wassim-tk/PCB-DC-Motor-Speed-Control/MP_Electronique_2025_liste_composants.pdf

Qté | Désignation | Valeur
1 | barrette sécable mâle (Pin Header) | 1x10 broches - 2.54mm
2 | bornier | à deux vis
2 | bornier | à trois vis
2 | bouton poussoir Omron | à souder sur circuit imprimé
1 | circuit intégré en boîtier DIP | 4027N
1 | circuit intégré en boîtier DIP | LM393N
1 | circuit intégré en boîtier DIP | NE555N
1 | circuit intégré en boîtier DIP | µA741
5 | condensateur céramique | 100nF
1 | condensateur céramique | 10nF
1 | condensateur céramique | 1nF
2 | condensateur chimique | 10µF/25V
5 | condensateur chimique | 1µF/25V
2 | condensateur chimique | 2200µF/25V
1 | condensateur plastique ou mica | 330nF/100V
5 | diode | 1N4004
3 | diode | 1N4148 ou 1N914
1 | diode | BYT08P-400 ou équivalent
4 | entretoise filetée hexagonale mâle/femelle + écrou | M3
2 | LED 5mm | rouge
3 | LED 5mm | verte
1 | MOSFET | IRF530
0,5 | plaque de circuit imprimé epoxy présensibilisée simple face | 300x200mm
1 | potentiomètre avec axe 6mm | 10K
1 | régulateur de tension | 7812
1 | régulateur de tension | 7912
1 | régulateur de tension | LM317T
1 | relais 12V à deux contacts inverseurs 5A/250V | G2R2
1 | résistance 1/4W | 10 ohm
10 | résistance 1/4W | 10K
1 | résistance 1/4W | 15K
6 | résistance 1/4W | 1K
1 | résistance 1/4W | 220 ohm
1 | résistance 1/4W | 22K
1 | résistance 1/4W | 4.7K
2 | résistance 1/4W | 470 ohm
2 | résistance 1/4W | 47K
1 | résistance 1/4W | 6,8K
1 | résistance ajustable horizontale 10mm | 2.2K
1 | résistance ajustable horizontale 10mm | 470 ohm
1 | support de circuit intégré LC | 16 broches
3 | support de circuit intégré LC | 8 broches
1 | transformateur | 220V/2x12V/12VA
1 | transistor NPN en boîtier métallique TO18 | 2N2222
2 | transistor NPN | BC547
3 | transistor PNP | BC557
