wassim-tk/PCB-DC-Motor-Speed-Control/final tempo/tempo_liste_comp.pdf

Qty | Description | Valeur
1 | bouton poussoir Omron | à souder sur circuit imprimé
1 | bornier | à deux vis
1 | résistance 1/4W | 1k
2 | résistance 1/4W | 10k
1 | résistance 1/4W | 100k
1 | Potentiometer | 1M
2 | condensateur céramique | 10nF /25V
1 | condensateur chimique | 100uF /25V
1 | diode | 1N4004
1 | diode | 1N4148DO35-10
1 | circuit intégré en boîtier DIP | NE555N
1 | LED 5mm | Rouge
1 | support de circuit intégré LC | 8 broches
