wassim-tk/PCB-DC-Motor-Speed-Control/rapport/hydro.png

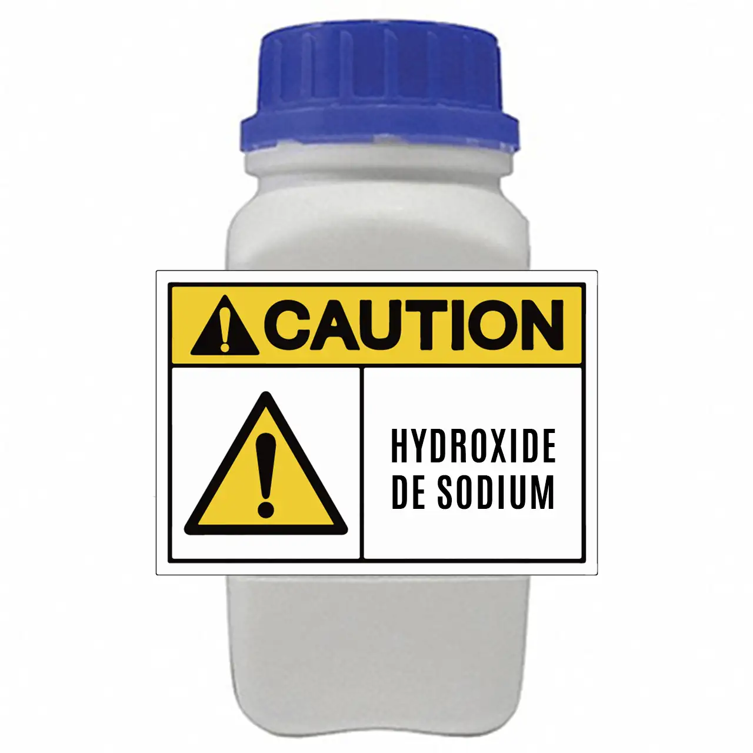
rapport/hydro.png
