wassim-tk/PCB-DC-Motor-Speed-Control/rapport/insoleuse.png

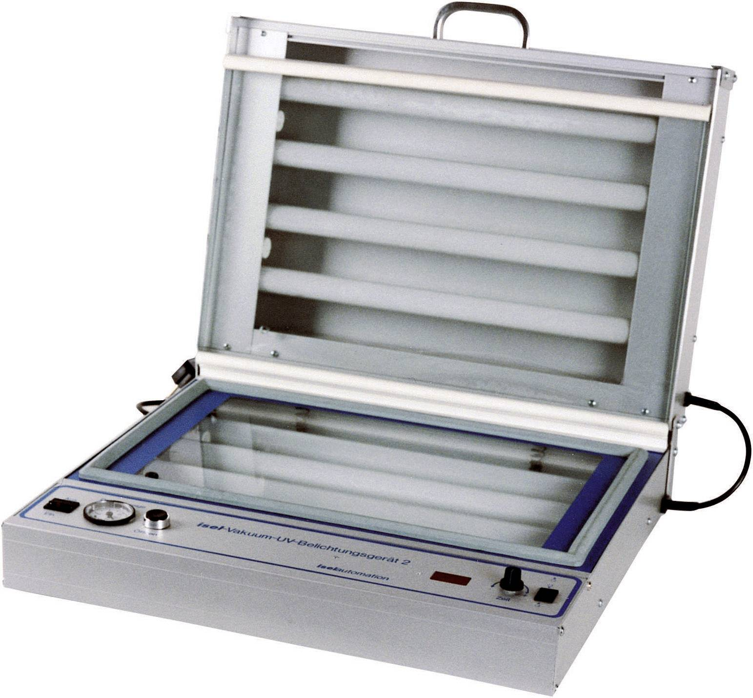
rapport/insoleuse.png
