wassim-tk/PCB-DC-Motor-Speed-Control/rapport/perch.png

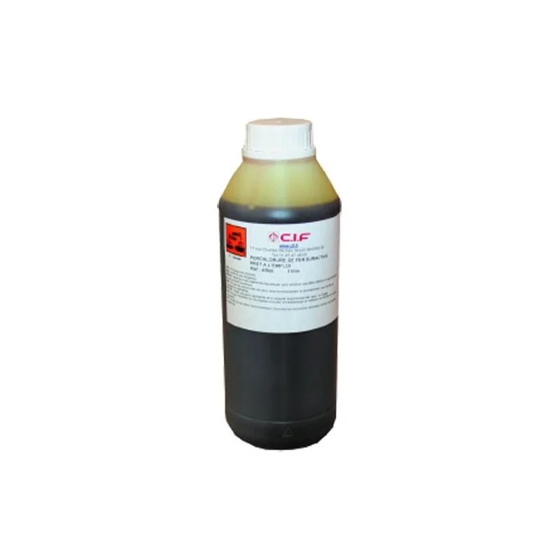
rapport/perch.png
