wassim-tk/PCB-DC-Motor-Speed-Control/rapport/sch.png

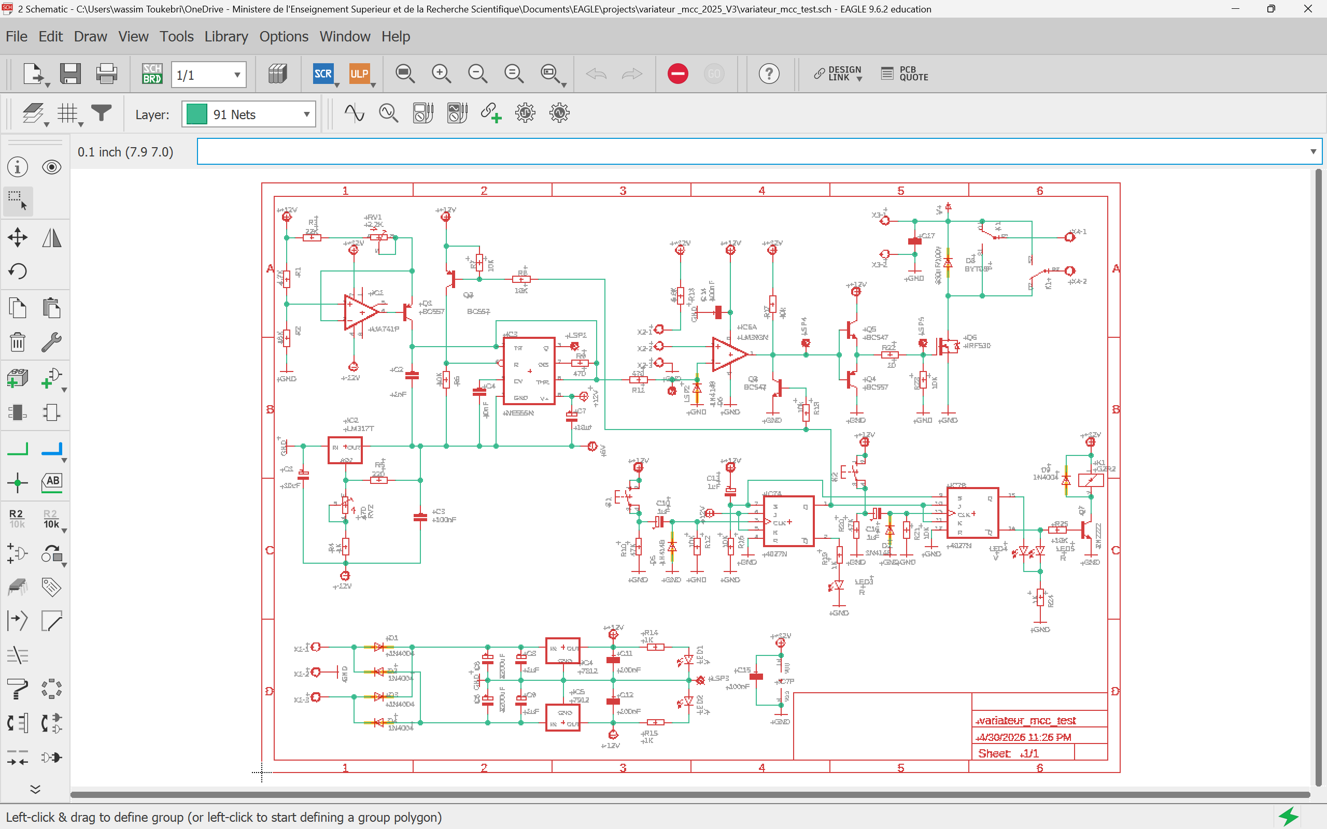
rapport/sch.png
