wassim-tk/PCB-DC-Motor-Speed-Control/rapport/sch_led_1.png

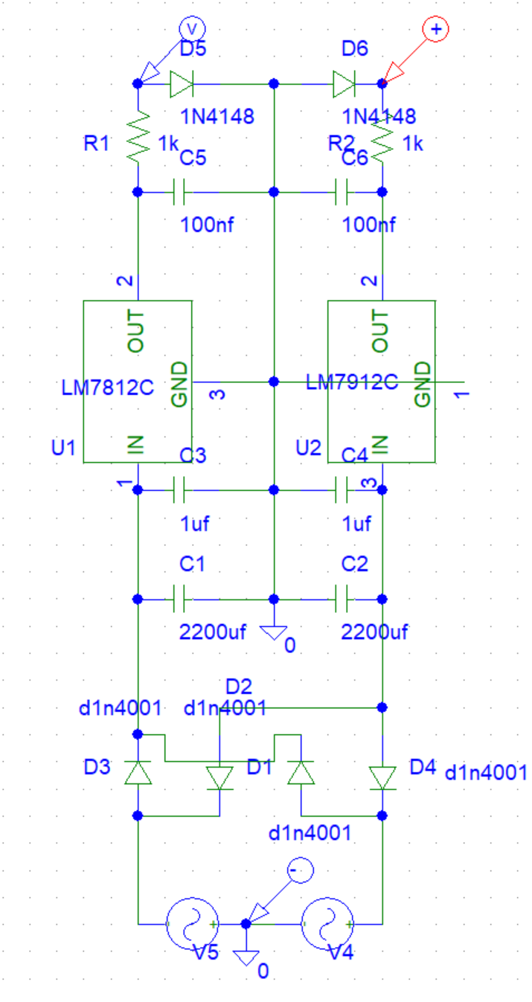
rapport/sch_led_1.png
