wassim-tk/PCB-DC-Motor-Speed-Control/rapport/sch_led_2.png

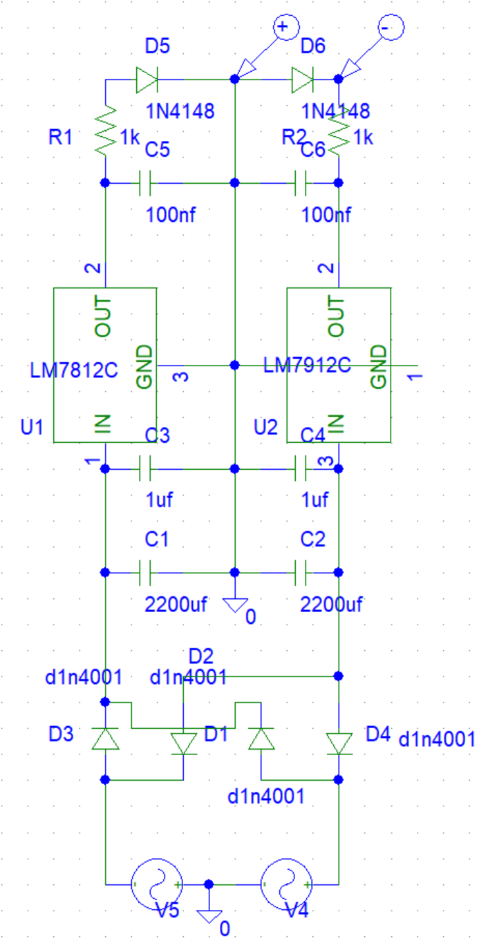
rapport/sch_led_2.png
