wassim-tk/PCB-DC-Motor-Speed-Control/rapport/sch_red.png

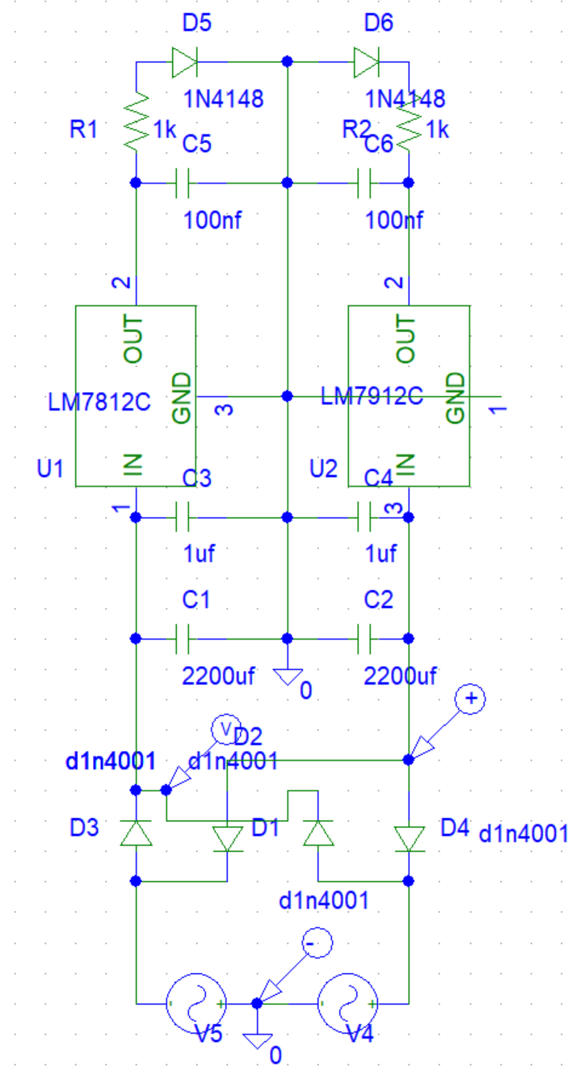
rapport/sch_red.png
