wassim-tk/PCB-DC-Motor-Speed-Control/rapport/sch_reg.png

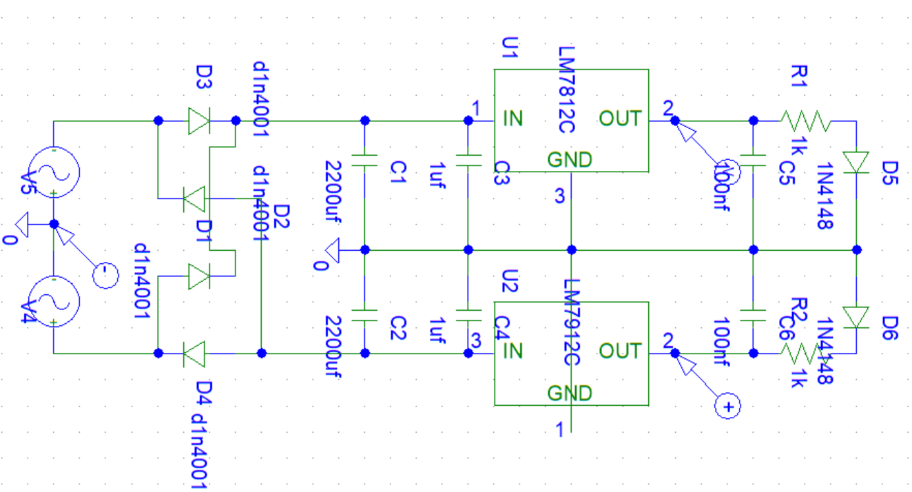
rapport/sch_reg.png
