wassim-tk/PCB-DC-Motor-Speed-Control/rapport/sim_led.png

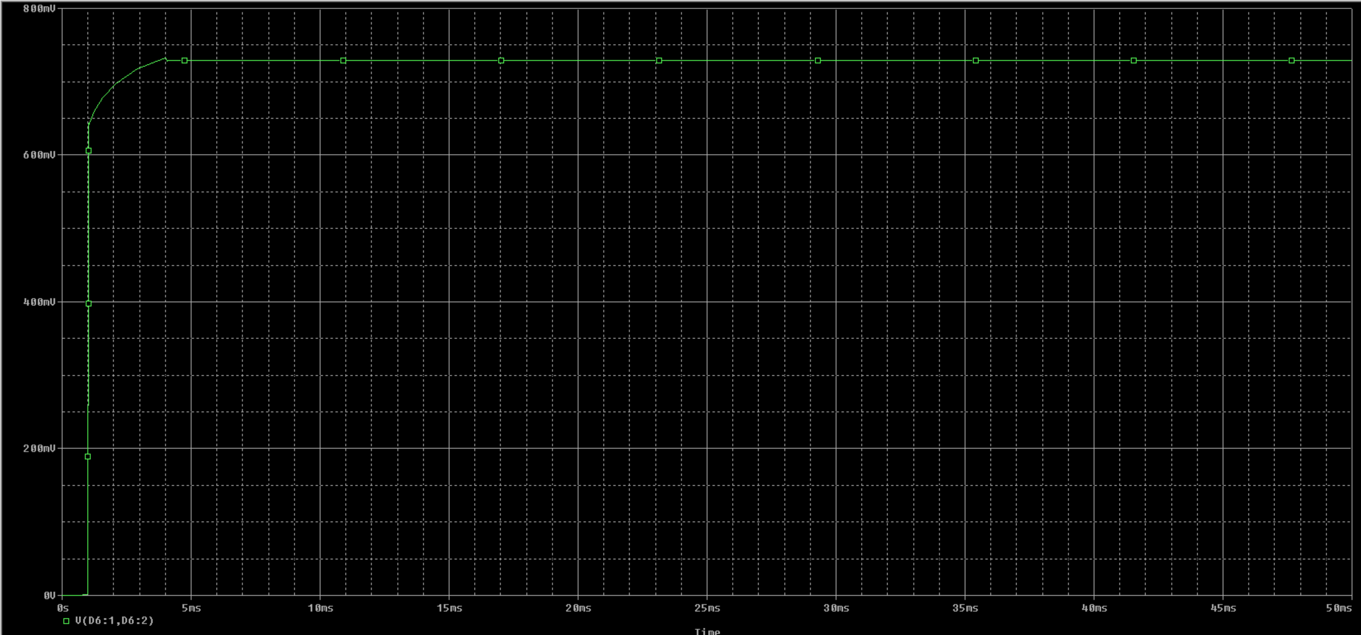
rapport/sim_led.png
