wassim-tk/PCB-DC-Motor-Speed-Control/rapport/soudage.png

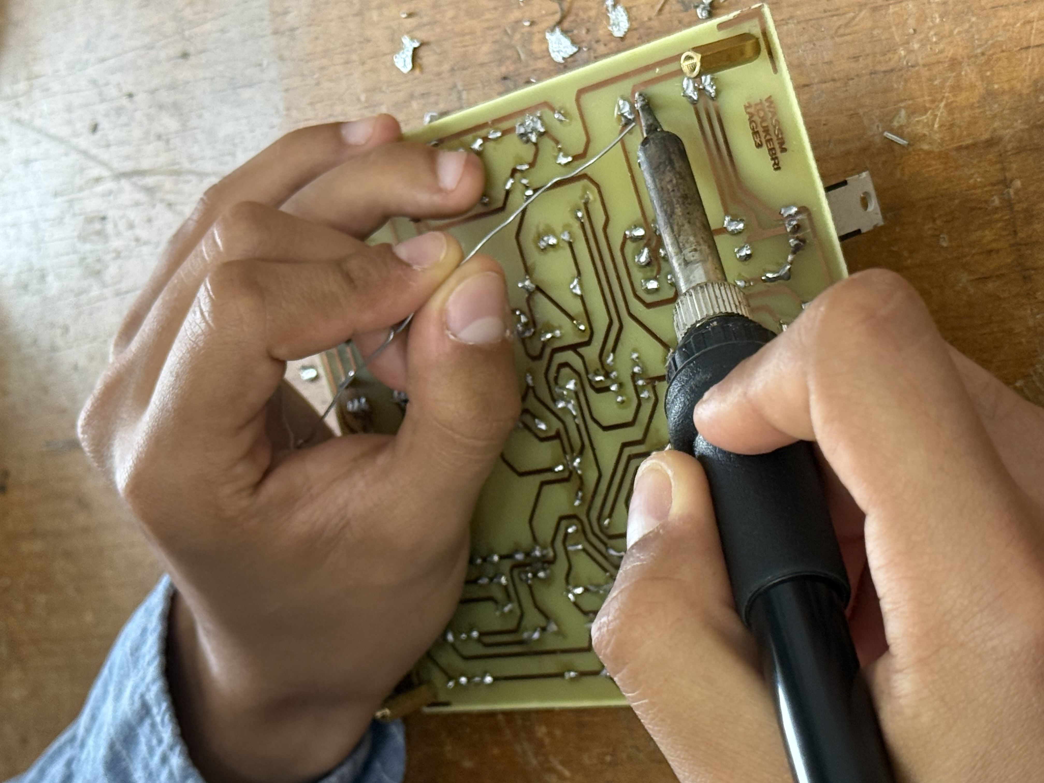
rapport/soudage.png
