wassim-tk/PCB-DC-Motor-Speed-Control/rapport/UV.jpg

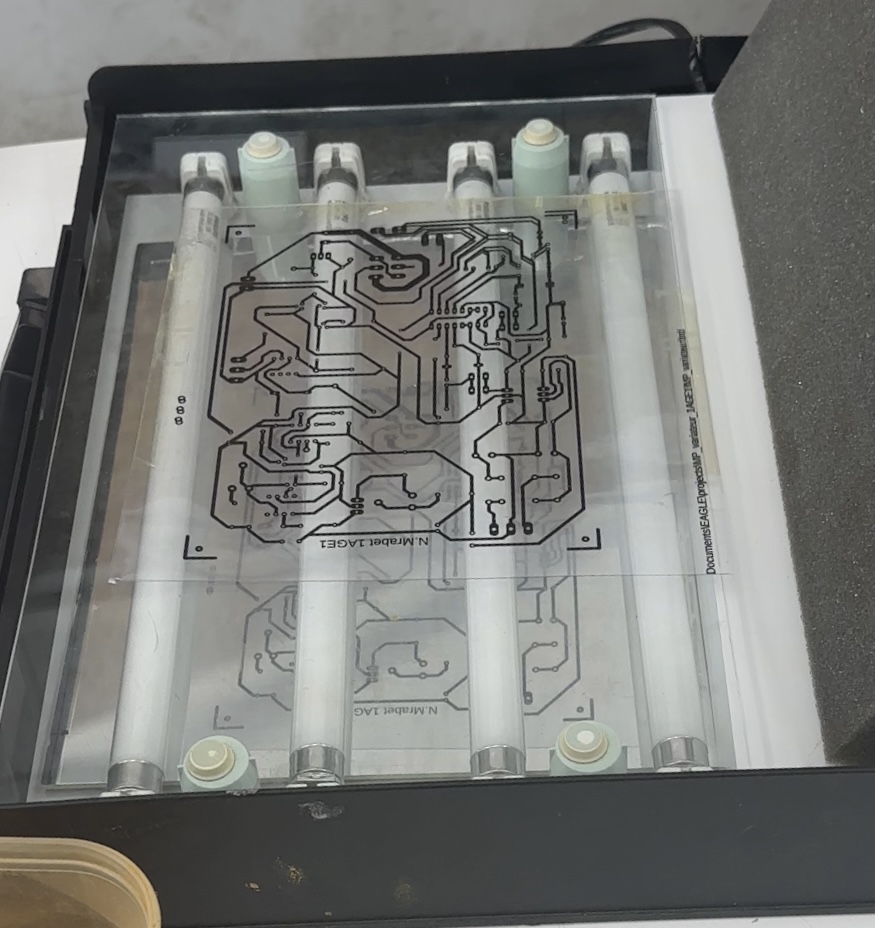
rapport/UV.jpg
