wassim-tk/PCB-DC-Motor-Speed-Control/rapport/partlist_variateur_mcc.xlsx

Sheet: Parts List
variateur_mcc_test - Parts List
Exported: 5/7/2026 10:07 PM | Project: variateur_mcc_2025_V3
Part | Value | Device | Package | Description | Category
C1 | 10uF | CPOL-EUE2.5-5 | E2,5-5 | POLARIZED CAPACITOR, European symbol | Capacitor
C2 | 1nF | C-EU050-030X075 | C050-030X075 | CAPACITOR, European symbol | Capacitor
C3 | 100nF | C-EU050-030X075 | C050-030X075 | CAPACITOR, European symbol | Capacitor
C4 | 10nF | C-EU050-030X075 | C050-030X075 | CAPACITOR, European symbol | Capacitor
C5 | 2200uF | CPOL-EUE5-13 | E5-13 | POLARIZED CAPACITOR, European symbol | Capacitor
C6 | 2200uF | CPOL-EUE5-13 | E5-13 | POLARIZED CAPACITOR, European symbol | Capacitor
C7 | 10uf | CPOL-EUE2.5-5 | E2,5-5 | POLARIZED CAPACITOR, European symbol | Capacitor
C8 | 1uF | CPOL-EUE2.5-5 | E2,5-5 | POLARIZED CAPACITOR, European symbol | Capacitor
C9 | 1uF | CPOL-EUE2.5-5 | E2,5-5 | POLARIZED CAPACITOR, European symbol | Capacitor
C10 | 1uF | CPOL-EUE2.5-5 | E2,5-5 | POLARIZED CAPACITOR, European symbol | Capacitor
C11 | 100nF | C-EU050-030X075 | C050-030X075 | CAPACITOR, European symbol | Capacitor
C12 | 100nF | C-EU050-030X075 | C050-030X075 | CAPACITOR, European symbol | Capacitor
C13 | 1uF | CPOL-EUE2.5-5 | E2,5-5 | POLARIZED CAPACITOR, European symbol | Capacitor
C14 | 100nF | C-EU050-030X075 | C050-030X075 | CAPACITOR, European symbol | Capacitor
C15 | 100nF | C-EU050-030X075 | C050-030X075 | CAPACITOR, European symbol | Capacitor
C16 | 1uF | CPOL-EUE2.5-5 | E2,5-5 | POLARIZED CAPACITOR, European symbol | Capacitor
C17 | 330nF/100v | C-EU150-054X183 | C150-054X183 | CAPACITOR, European symbol | Capacitor
D1 | 1N4004 | 1N4004 | DO41-10 | DIODE | Diode
D2 | 1N4004 | 1N4004 | DO41-10 | DIODE | Diode
D3 | 1N4004 | 1N4004 | DO41-10 | DIODE | Diode
D4 | 1N4004 | 1N4004 | DO41-10 | DIODE | Diode
D5 | 1N4148 | 1N4148DO35-10 | DO35-10 | DIODE | Diode
D6 | 1N4148 | 1N4148DO35-10 | DO35-10 | DIODE | Diode
D7 | 1N4148 | 1N4148DO35-10 | DO35-10 | DIODE | Diode
D8 | BYT08P | BYT08P | TO220ACS | DIODE | Diode
D9 | 1N4004 | 1N4004 | DO41-10 | DIODE | Diode
IC1 | UA741P | UA741P | DIL08 | OP AMP | IC
IC2 | LM317T | LM317TS | 317TS | VOLTAGE REGULATOR | IC
IC3 | NE555N | NE555N | DIL08 | TIMER | IC
IC4 | 7812 | 78XXS | 78XXS | VOLTAGE REGULATOR | IC
IC5 | 7912 | 79XXS | 79XXS | VOLTAGE REGULATOR | IC
IC6 | LM393N | LM393N | DIL08 | COMPARATOR | IC
IC7 | 4027N | 4027N | DIL16 | Dual JK FLIP FLOP | IC
K1 | G2R2 | G2R2 | G2R2 | RELAY | Relay
LED1 | V | LED5MM | LED5MM | LED | LED
LED2 | V | LED5MM | LED5MM | LED | LED
LED3 | R | LED5MM | LED5MM | LED | LED
LED4 | V | LED5MM | LED5MM | LED | LED
LED5 | R | LED5MM | LED5MM | LED | LED
LSP1 | LSP10 | LSP10 | LSP10 | SOLDER PAD drill 1.0 mm | Solder Pad
LSP2 | LSP10 | LSP10 | LSP10 | SOLDER PAD drill 1.0 mm | Solder Pad
LSP3 | LSP10 | LSP10 | LSP10 | SOLDER PAD drill 1.0 mm | Solder Pad
LSP4 | LSP10 | LSP10 | LSP10 | SOLDER PAD drill 1.0 mm | Solder Pad
LSP5 | LSP10 | LSP10 | LSP10 | SOLDER PAD drill 1.0 mm | Solder Pad
Q1 | BC557 | BC557 | TO92 | PNP Transistor | Transistor
Q2 | BC557 | BC557 | TO92 | PNP Transistor | Transistor
Q3 | BC547 | BC547 | TO92 | NPN TRANSISTOR | Transistor
Q4 | BC557 | BC557 | TO92 | PNP Transistor | Transistor
Q5 | BC547 | BC547 | TO92 | NPN TRANSISTOR | Transistor
Q6 | IRF530 | IRF530 | TO220BV | HEXFET Power MOSFET | Transistor
Q7 | 2N2222 | 2N2222 | TO18 | NPN TRANSISTOR | Transistor
R1 | 4.7K | R-EU_0207/10 | 0207/10 | RESISTOR, European symbol | Resistor
R2 | 15K | R-EU_0207/10 | 0207/10 | RESISTOR, European symbol | Resistor
R3 | 22K | R-EU_0207/10 | 0207/10 | RESISTOR, European symbol | Resistor
R4 | 1K | R-EU_0207/10 | 0207/10 | RESISTOR, European symbol | Resistor
R5 | 220 | R-EU_0207/10 | 0207/10 | RESISTOR, European symbol | Resistor
R6 | 10K | R-EU_0207/10 | 0207/10 | RESISTOR, European symbol | Resistor
R7 | 10K | R-EU_0207/10 | 0207/10 | RESISTOR, European symbol | Resistor
R8 | 10K | R-EU_0207/10 | 0207/10 | RESISTOR, European symbol | Resistor
R9 | 470 | R-EU_0207/10 | 0207/10 | RESISTOR, European symbol | Resistor
R10 | 47K | R-EU_0207/10 | 0207/10 | RESISTOR, European symbol | Resistor
R11 | 470 | R-EU_0207/10 | 0207/10 | RESISTOR, European symbol | Resistor
R12 | 10K | R-EU_0207/10 | 0207/10 | RESISTOR, European symbol | Resistor
R13 | 6.8K | R-EU_0207/10 | 0207/10 | RESISTOR, European symbol | Resistor
R14 | 1K | R-EU_0207/10 | 0207/10 | RESISTOR, European symbol | Resistor
R15 | 1K | R-EU_0207/10 | 0207/10 | RESISTOR, European symbol | Resistor
R16 | 10K | R-EU_0207/10 | 0207/10 | RESISTOR, European symbol | Resistor
R17 | 10k | R-EU_0207/10 | 0207/10 | RESISTOR, European symbol | Resistor
R18 | 10k | R-EU_0207/10 | 0207/10 | RESISTOR, European symbol | Resistor
R19 | 1K | R-EU_0207/10 | 0207/10 | RESISTOR, European symbol | Resistor
R20 | 47K | R-EU_0207/10 | 0207/10 | RESISTOR, European symbol | Resistor
R21 | 10K | R-EU_0207/10 | 0207/10 | RESISTOR, European symbol | Resistor
R22 | 10 | R-EU_0207/10 | 0207/10 | RESISTOR, European symbol | Resistor
R23 | 10K | R-EU_0207/10 | 0207/10 | RESISTOR, European symbol | Resistor
R24 | 1K | R-EU_0207/10 | 0207/10 | RESISTOR, European symbol | Resistor
R25 | 10K | R-EU_0207/10 | 0207/10 | RESISTOR, European symbol | Resistor
RV1 | 2.2K | TRIM_EU-LI10 | LI10 | POTENTIOMETER | Potentiometer
RV2 | 470 | TRIM_EU-LI10 | LI10 | POTENTIOMETER | Potentiometer
S1 |  | 10-XX | B3F-10XX | OMRON SWITCH | Switch
S2 |  | 10-XX | B3F-10XX | OMRON SWITCH | Switch
X1 |  | AK300/3 | AK300/3 | CONNECTOR | Connector
X2 |  | AK300/3 | AK300/3 | CONNECTOR | Connector
X3 |  | AK300/2 | AK300/2 | CONNECTOR | Connector
X4 |  | AK300/2 | AK300/2 | CONNECTOR | Connector

Sheet: Summary
Category | Count
Capacitor | 17
Connector | 4
Diode | 9
IC | 7
LED | 5
Potentiometer | 2
Relay | 1
Resistor | 25
Solder Pad | 5
Switch | 2
Transistor | 7
TOTAL
