wassim-tk/PCB-DC-Motor-Speed-Control/composantsfinal1.csv.xlsx

Qty | Value | Device | Package | Parts | Description | MF | MPN | OC_FARNELL | OC_NEWARK | POPULARITY | SPICEPREFIX
1 |  | 10-XX | B3F-10XX | S1 | OMRON SWITCH |  | B3F-1000 | 176432 | 36M3542 | 72
1 |  | AK300/2 | AK300/2 | X1 | CONNECTOR |  |  | unknown | unknown | 16
1 |  | LED5MM | LED5MM | LED2 | LED |  |  |  |  | 93
1 | 100k | R-EU_0207/10 | 0207/10 | R2 | RESISTOR, European symbol |  |  |  |  | 81 | R
1 | 100ÂµF | CPOL-EUE3.5-10 | E3,5-10 | C3 | POLARIZED CAPACITOR, European symbol |  |  |  |  | 5 | C
2 | 10K | R-EU_0207/10 | 0207/10 | R3, R4 | RESISTOR, European symbol |  |  |  |  | 81 | R
2 | 10nF | C-EU050-025X075 | C050-025X075 | C1, C5 | CAPACITOR, European symbol |  |  |  |  | 29 | C
1 | 1K | R-EU_0207/10 | 0207/10 | R5 | RESISTOR, European symbol |  |  |  |  | 81 | R
1 | 1M | 3RP/1610N | 3RP/1610N | R1 | 16mm Potentiometer one level |  |  |  |  | 8
1 | 1N4004 | 1N4004 | DO41-10 | D1 | DIODE |  |  |  |  | 82
1 | 1N4148DO35-10 | 1N4148DO35-10 | DO35-10 | D2 | DIODE |  |  |  |  | 21
1 | NE555N | NE555N | DIL08 | IC1 | TIMER |  |  |  |  | 16
