wassim-tk/PCB-DC-Motor-Speed-Control/final tempo/Dossier_technique_carte_temporisateur_WASSIM_TOUKEBRI_1AGE3.pdf

A

5

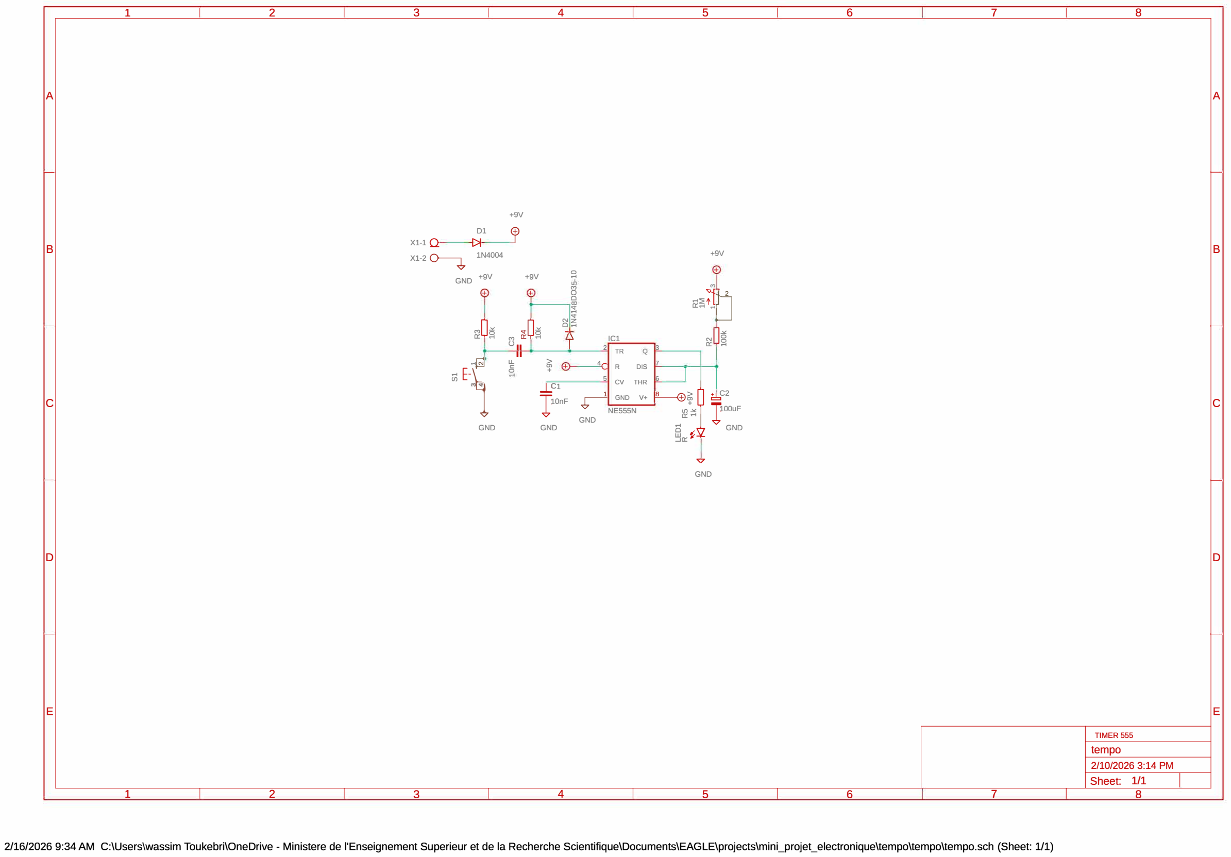
[picture p59: page 1]

1 | I | 2 | I | 3 | I | 4

+9V
D1

Xl-1 Q l>I 1

B 1N4004 Xl-2

0

GND +9V | +9V | .-<
| | (")
+ | + | 0
| | Cl
| | " .-<
| | "
[ ]5 | i ]5
- NZ Cl M

.-< | (") | .-<
U II | r

II

# uJ E-'"

,

S ·
LL | >
C | C) | + 0 | +
"'" | ...L.Cl
C | J10nF
GND | GND

D

E

1 | I | 2 | I | 3 | I | 4

I

ICl

### 2 TR

4 R | DIS
5 | CV | THR r GND | V+

NE555N
GND

I

+9V

+
"'
.-< j

0::.-< ,-<
N Jg
3 | c:: | .-<

7

### 6 i

# [ l bC2

# "'-" rlOOuF

[l'..-i

.-i | ? | GND fil s ...JC::

'<;7
GND

5

I | 6 | 7
I | 6 | 7

2/16/2026 9:34AM C:\Users\wassim Toukebri\OneDrive - Ministere de l'Enseignement Superieur et de la Recherche Scientifique\Documents\EAGLE\projects\mini_projet_electronique\tempo\tempo\tempo.sch (Sheet 1/1)

I 8

A

B

C

D

E
TIMER 555

# tempo

2/10/2026 3:14 PM

# Sheet: 1/1 I

I 8

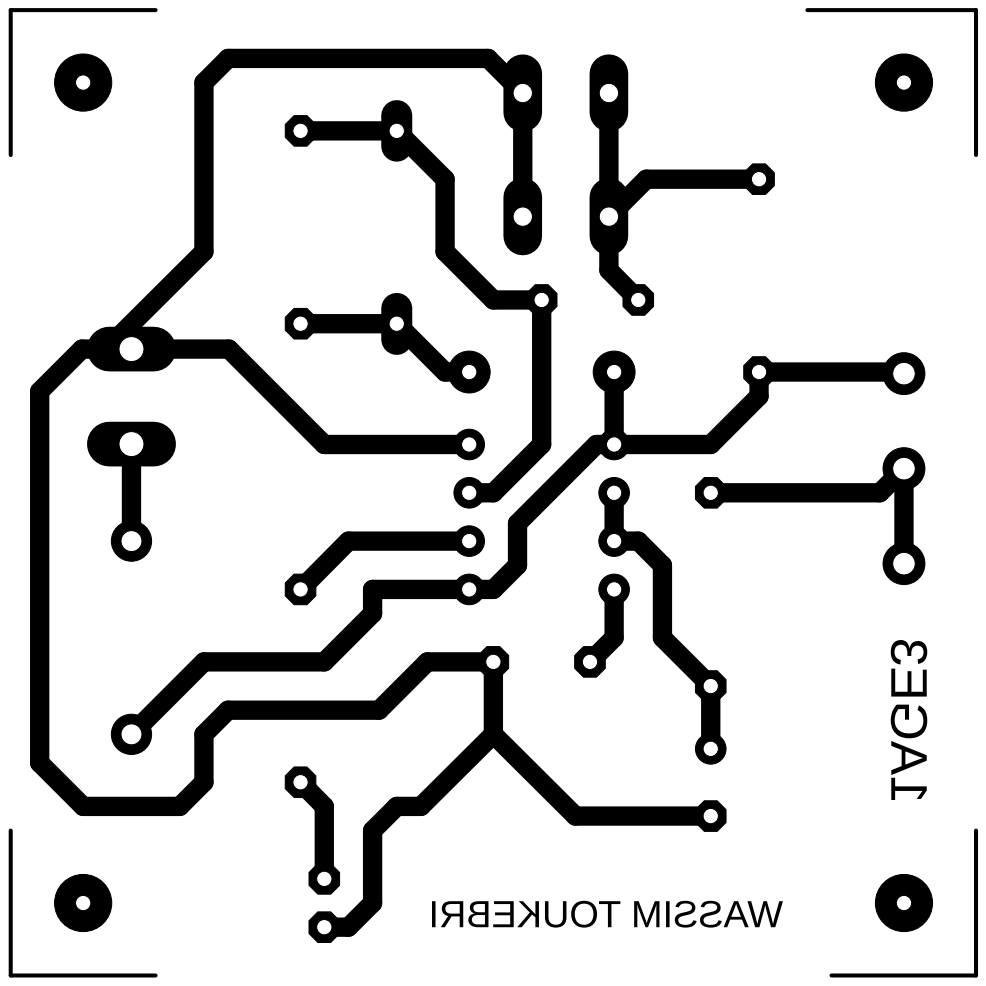
[picture p60: page 2]

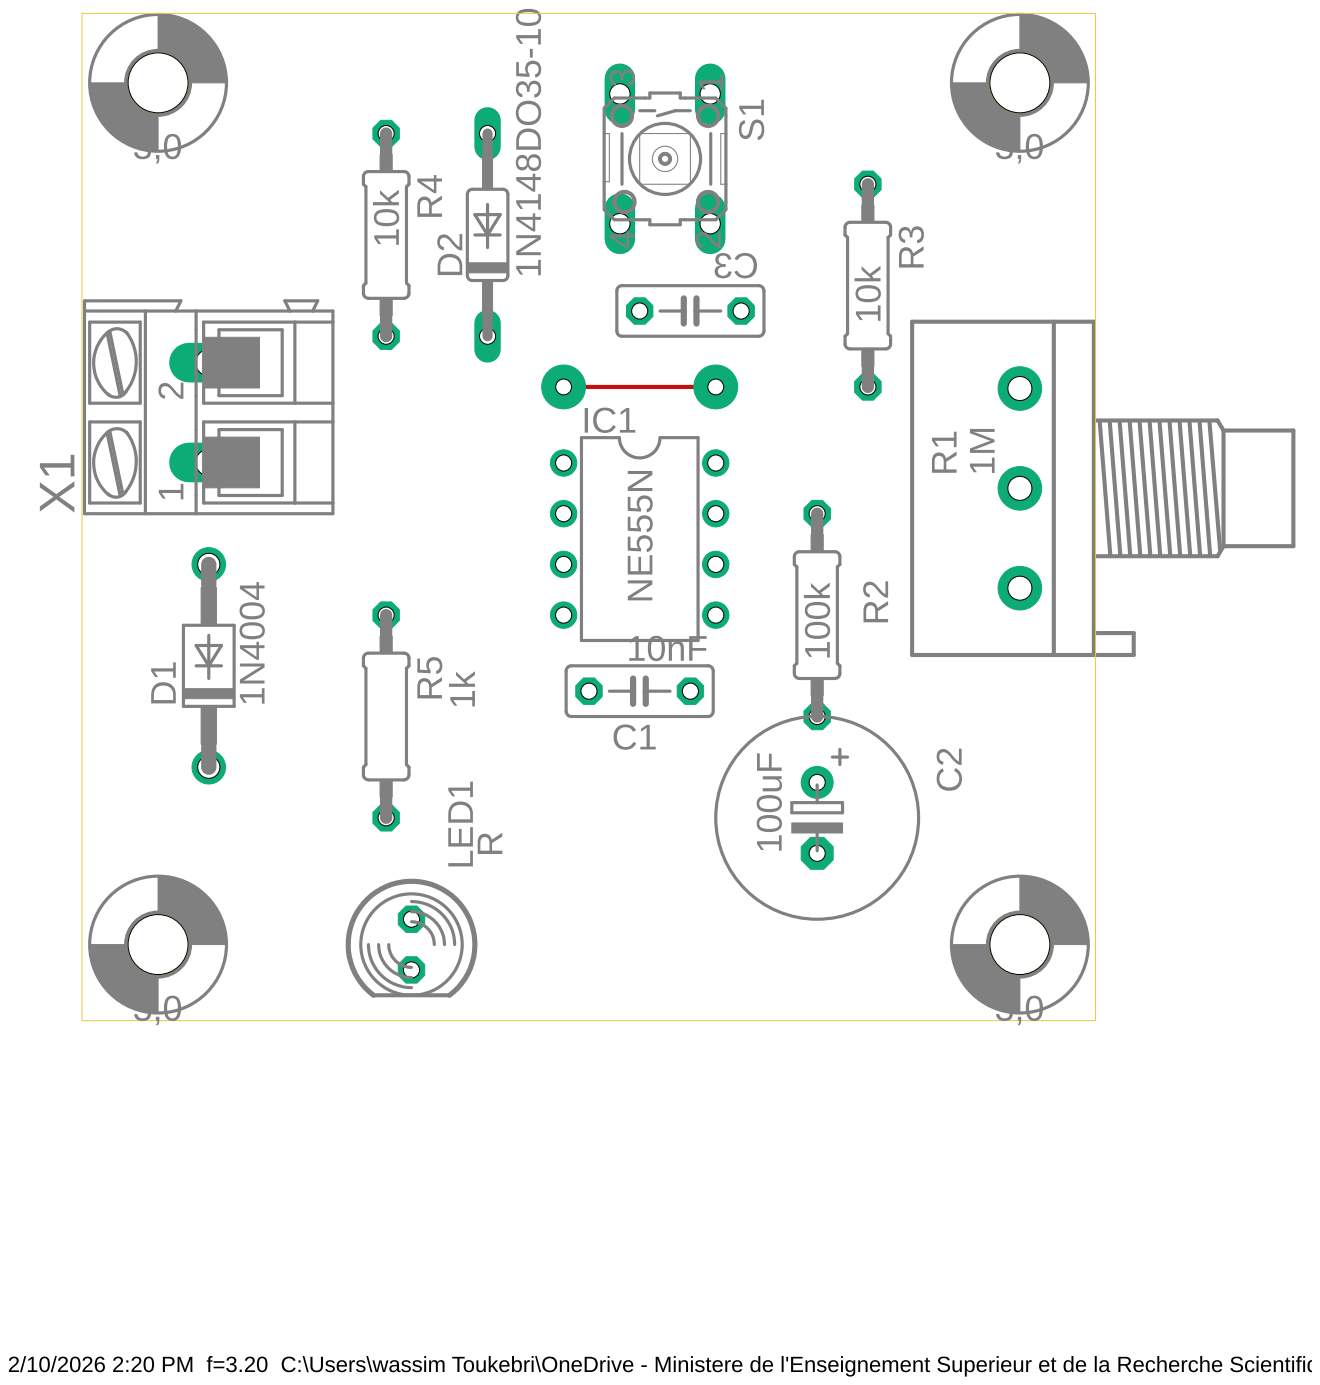
[picture p61: page 3]

Qty | Description | Valeur
1 | bouton poussoir Omron | à souder sur circuit imprimé
1 | bornier | à deux vis
1 | résistance 1/4W | 1k
2 | résistance 1/4W | 10k
1 | résistance 1/4W | 100k
1 | Potentiometer | 1M
2 | condensateur céramique | 10nF /25V
1 | condensateur chimique | 100uF /25V
1 | diode | 1N4004
1 | diode | 1N4148DO35-10
1 | circuit intégré en boîtier DIP | NE555N
1 | LED 5mm | Rouge
1 | support de circuit intégré LC | 8 broches
