wassim-tk/PCB-DC-Motor-Speed-Control/rapport/variateur_mcc_sch.pdf

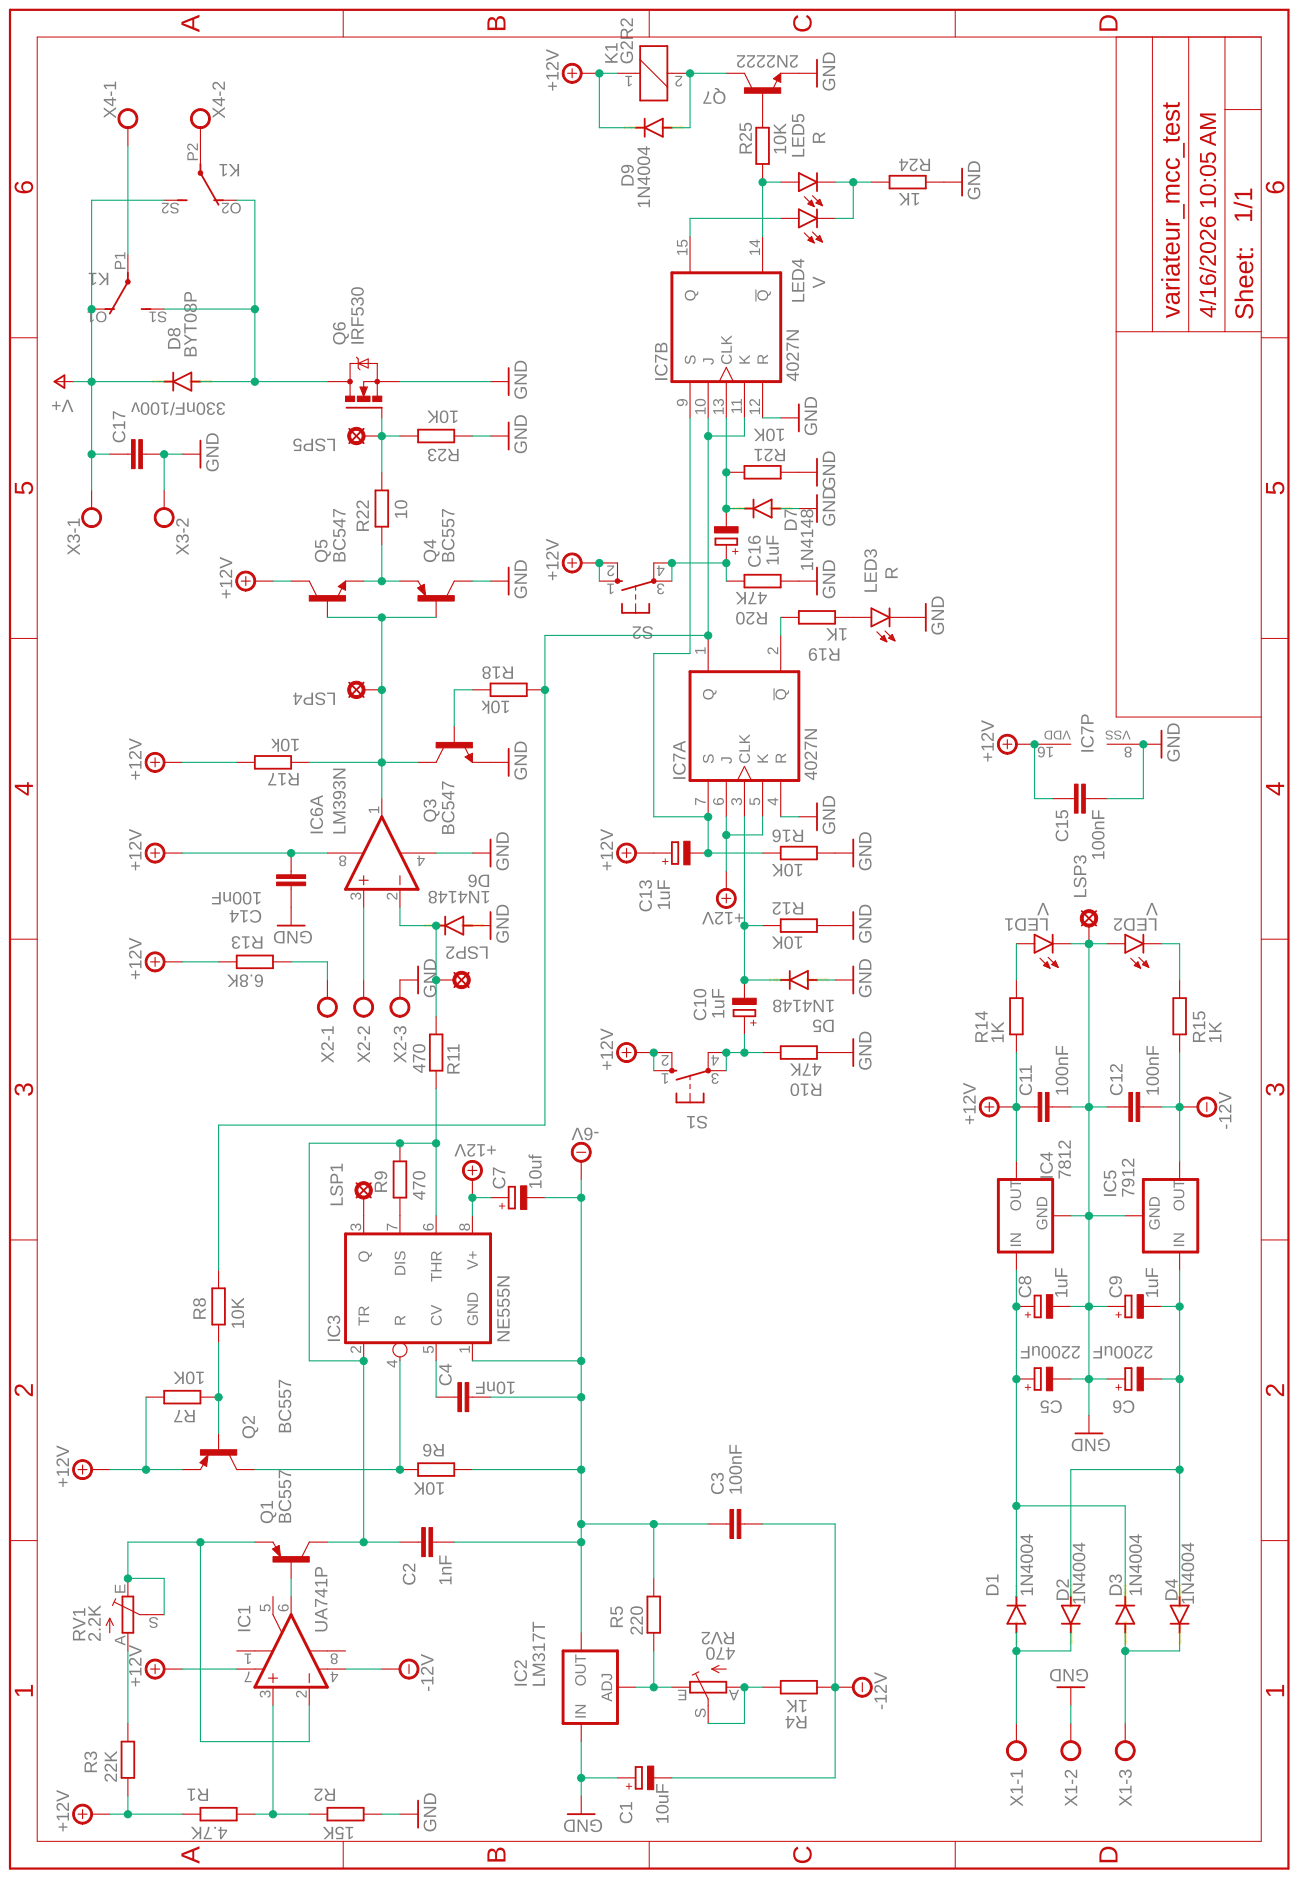
[picture p62: page 1]
