wassim-tk/PCB-DC-Motor-Speed-Control/rapport/variateur_mcc_test_imp.pdf

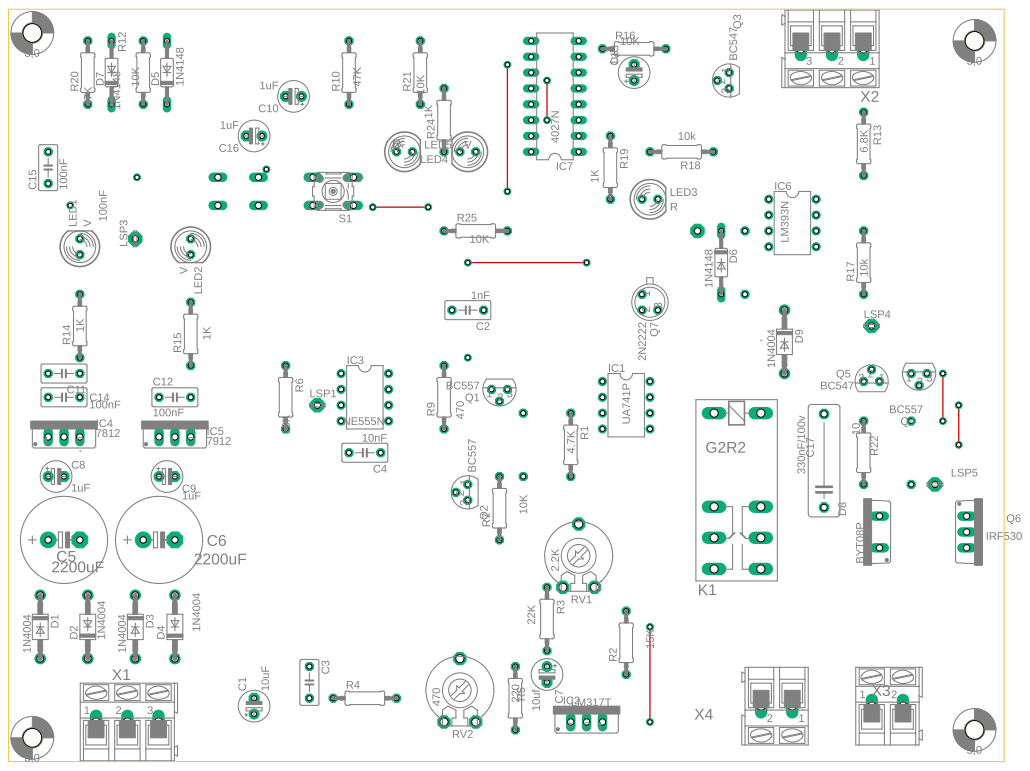
[picture p63: page 1]
