wassim-tk/PCB-DC-Motor-Speed-Control/rapport/variateur_mcc_test_typon.pdf

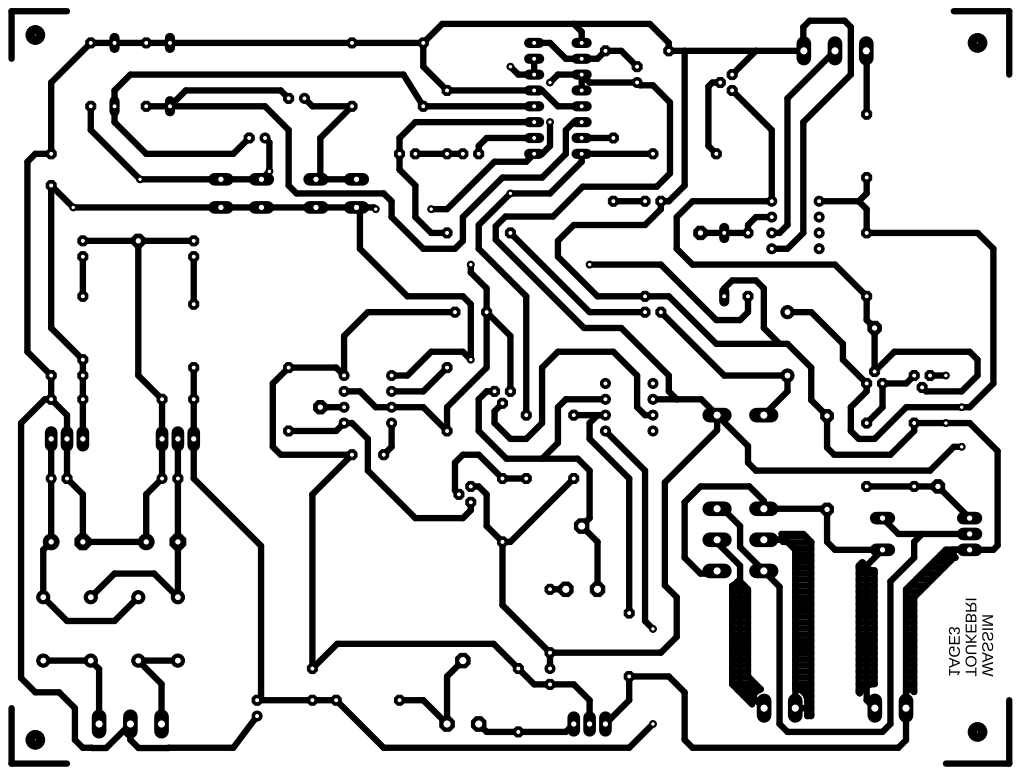
[picture p64: page 1]
