wassim-tk/PCB-DC-Motor-Speed-Control/MP_Electronique_2025_sch.pdf

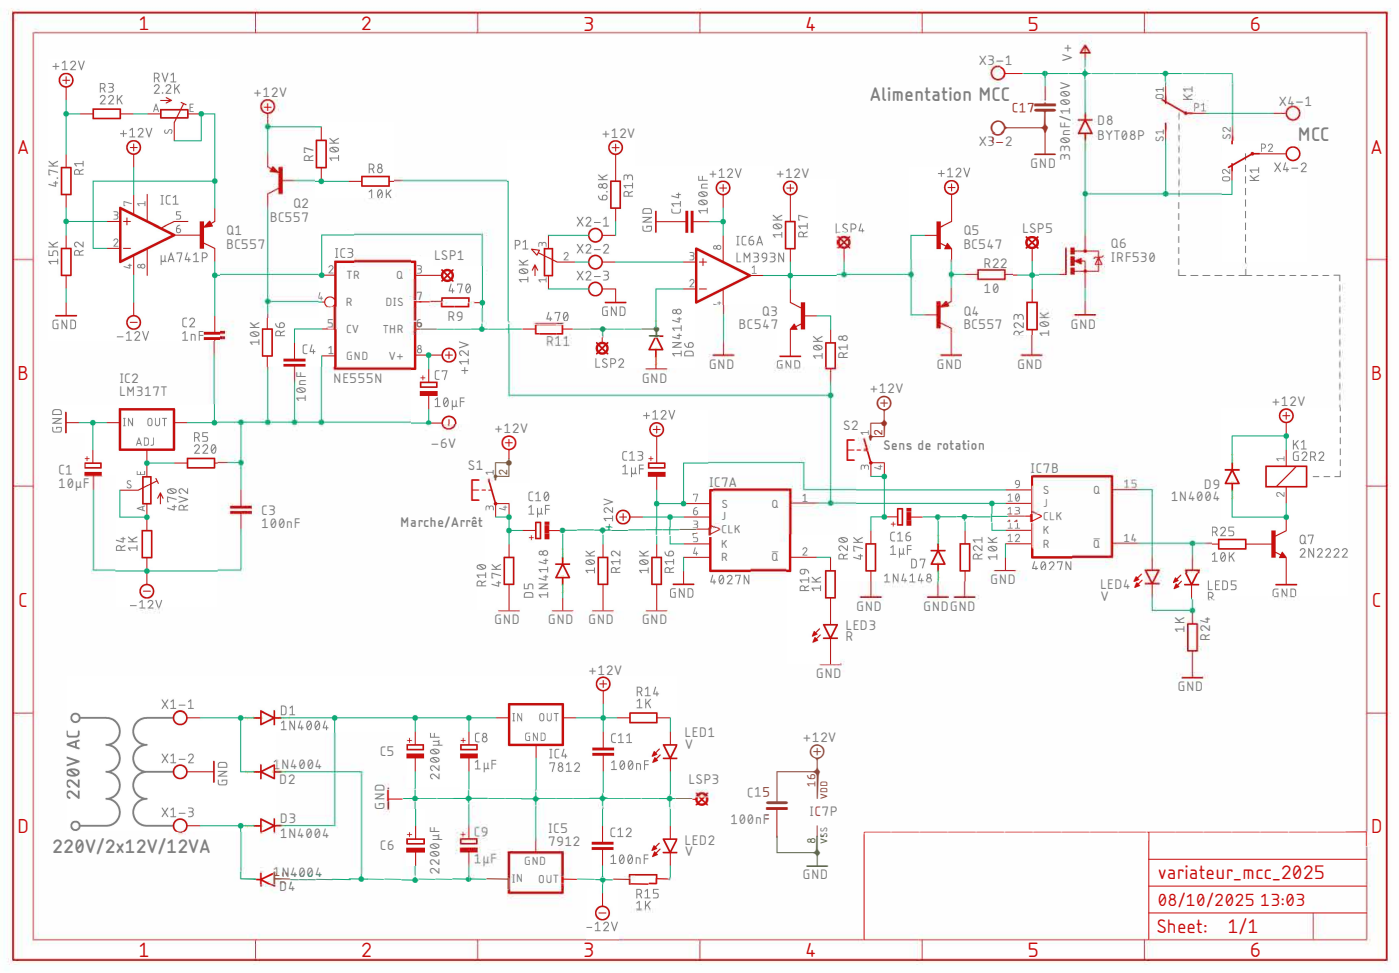
[picture p65: page 1]
