wassim-tk/PCB-DC-Motor-Speed-Control/final tempo/tempo_sch.pdf

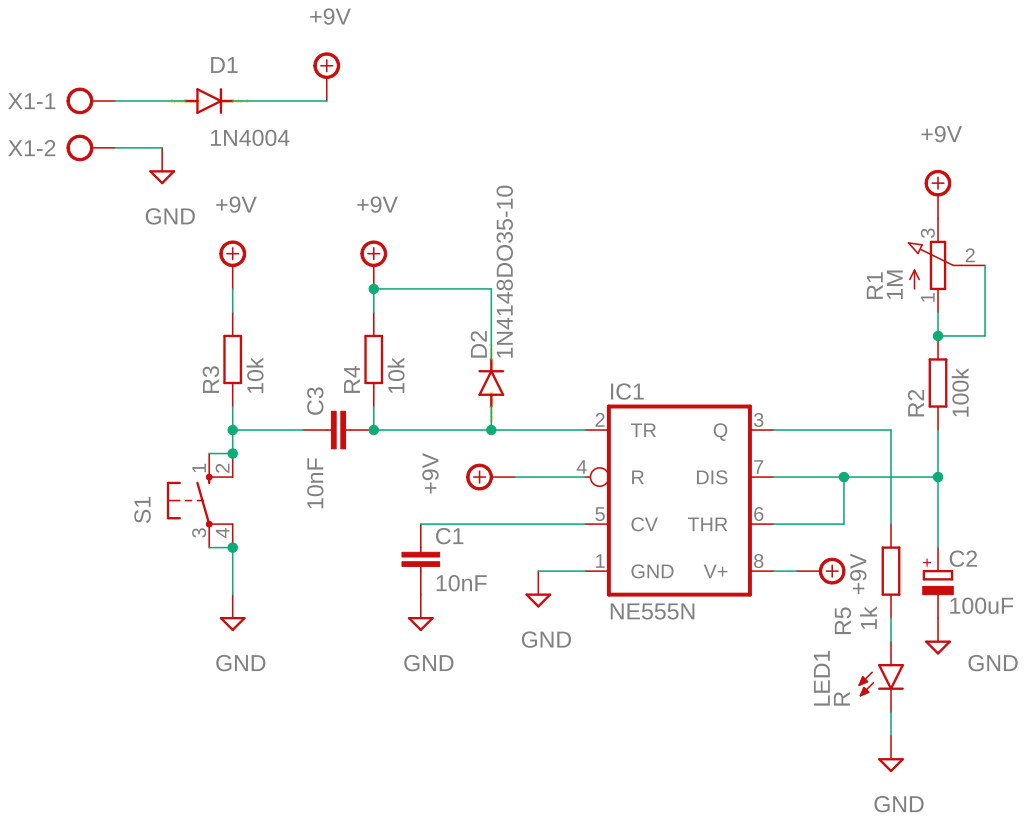
[picture p66: page 1]
